CRLG/HW_AXIFACE/README.md

# HW_AXIFACE
Carte électronique AXIFACE pour servo-moteurs AX: schéma et routage
