CRLG/HW_AXIFACE/output/Axiface.pdf

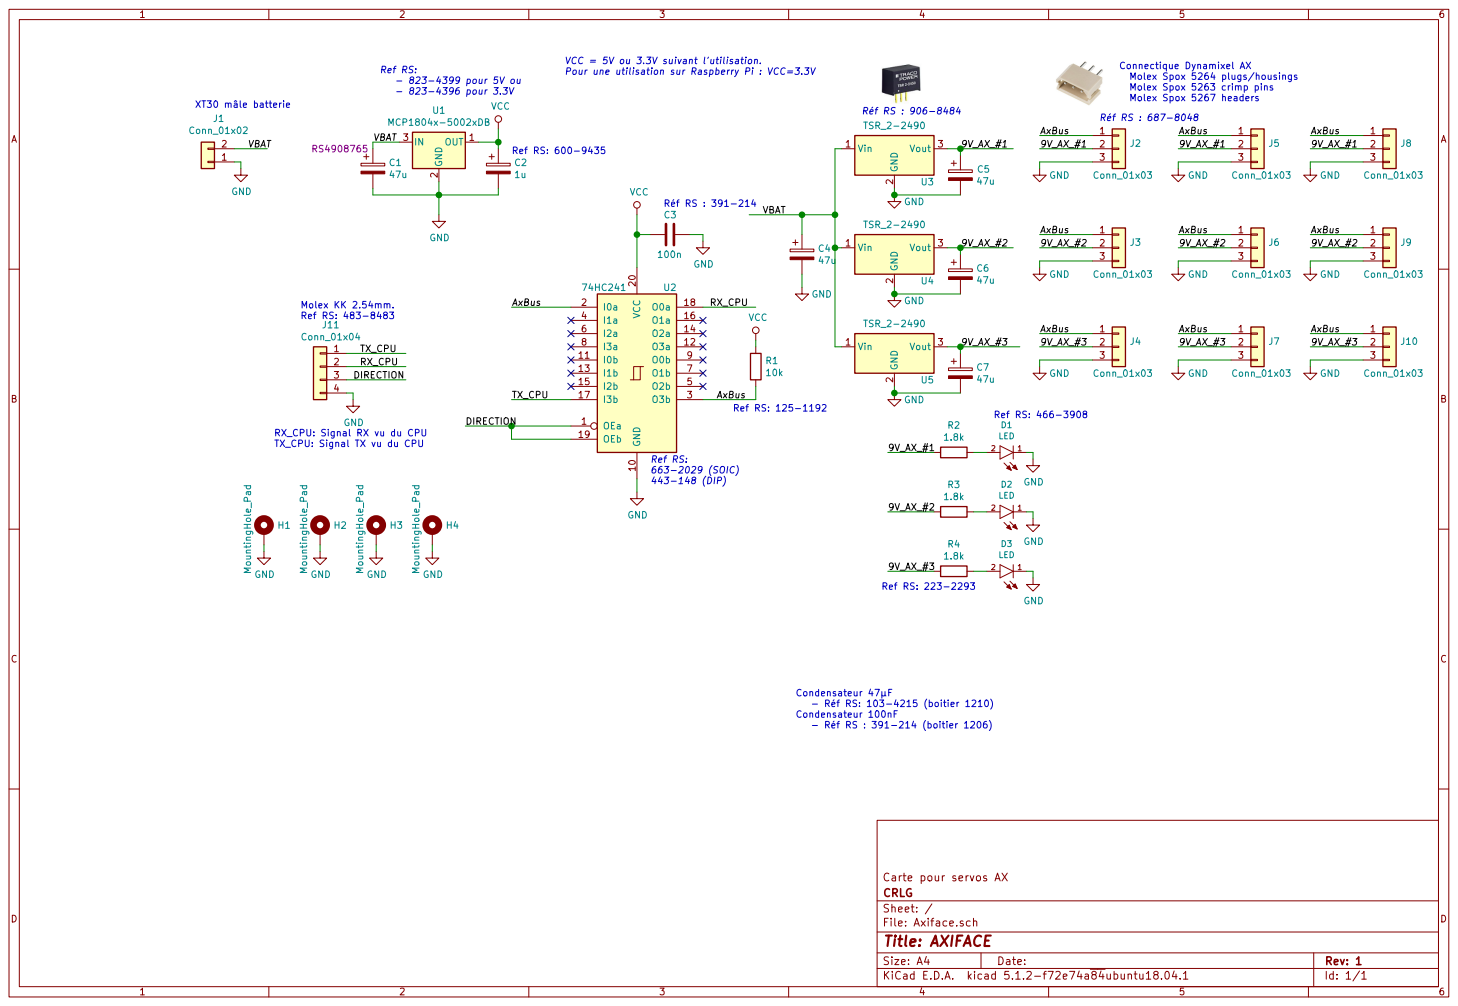
[picture p1: page 1]

Connectique Dynamixel AX
Molex Spox 5264 plugs/housings
Molex Spox 5263 crimp pins
Molex Spox 5267 headers Réf RS : 687-8048

2 Vout 3 U5 TSR_2-2490 GND GND GND

TX_CPU Molex KK 2.54mm. Ref RS: 483-8483
J11 Conn_01x04 GND

Ref RS: 223-2293 Ref RS: 125-1192

RX_CPU: Signal RX vu du CPU
TX_CPU: Signal TX vu du CPU

- Réf RS: 103-4215 (boitier 1210) Condensateur 100nF

Carte pour servos AX
File: Axiface.sch Sheet: / CRLG
