CRLG/HW_AXIFACE/Axiface.kicad_pcb

## KiCad design Axiface.kicad_pcb (2020-08-28)

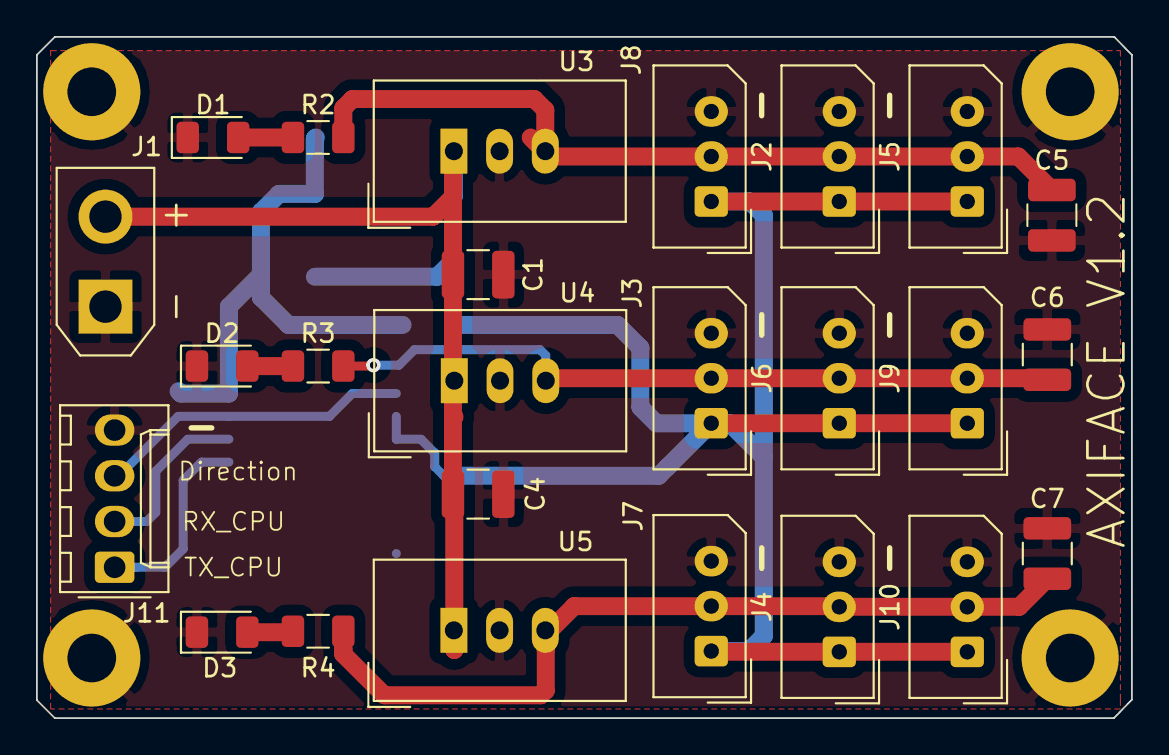
[picture p2: board Axiface.kicad_pcb from above]

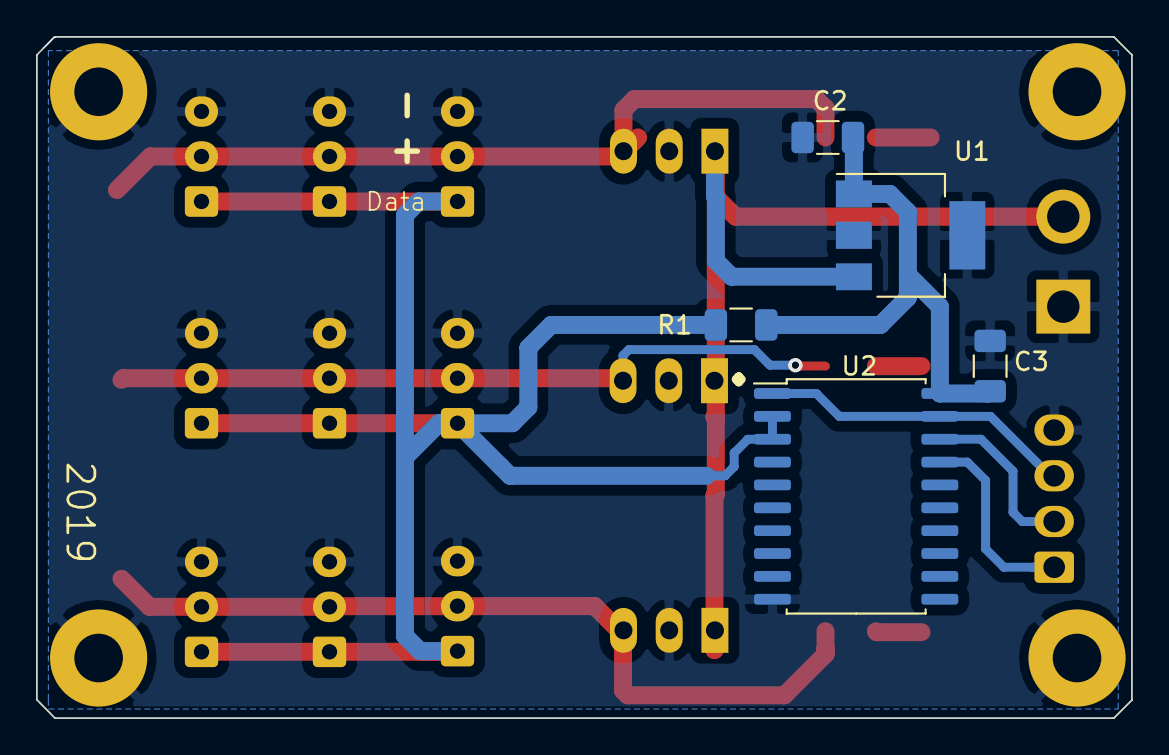
[picture p3: board Axiface.kicad_pcb from below]

Board: 2 copper layers, 60.8 x 37.8 mm, 34 parts (5 on the bottom side), 13 nets.

Parts:
C1, C4, C5, C6, C7: 47u; C_1210_3225Metric
C2: 1u; C_1206_3216Metric
C3: 100n; C_1206_3216Metric
D1, D2, D3: LED; LED_1206_3216Metric
H1, H2, H3, H4: MountingHole_Pad; MountingHole_2.7mm_M2.5_Pad
J1: Conn_01x02; AMASS_XT30UPB-F_1x02_P5.0mm_Vertical
J2, J3, J4, J5, J6, J7, J8, J9, J10: Conn_01x03; Molex_SPOX_5267-03A_1x03_P2.50mm_Vertical
J11: Conn_01x04; Molex_KK-254_AE-6410-04A_1x04_P2.54mm_Vertical
R1: 10k; R_1206_3216Metric
R2, R3, R4: 1.8k; R_1206_3216Metric
U1: MCP1804x-5002xDB; SOT-223-3_TabPin2
U2: 74HC241; SOIC-20W_7.5x12.8mm_P1.27mm
U3, U4, U5: TSR_2-2490; Converter_DCDC_TRACO_TSR-2_THT

Connections:
/9V_AX_#1: C5.1, J2.2, J5.2, J8.2, R2.2, U3.3
/9V_AX_#2: C6.1, J3.2, J6.2, J9.2, R3.2, U4.3
/9V_AX_#3: C7.1, J4.2, J7.2, J10.2, R4.2, U5.3
/AxBus: J2.1, J3.1, J4.1, J5.1, J6.1, J7.1, J8.1, J9.1, J10.1, R1.2, U2.2, U2.3
/DIRECTION: J11.3, U2.1, U2.19
/RX_CPU: J11.2, U2.18
/TX_CPU: J11.1, U2.17
/VBAT: C1.1, C4.1, J1.2, U1.3, U3.1, U4.1, U5.1
GND: C1.2, C2.2, C3.1, C4.2, C5.2, C6.2, C7.2, D1.1, D2.1, D3.1, H1.1, H2.1, H3.1, H4.1, J1.1, J2.3, J3.3, J4.3, J5.3, J6.3, J7.3, J8.3, J9.3, J10.3, J11.4, U1.2, U2.10, U3.2, U4.2, U5.2
unnamed: D1.2, R2.1
unnamed: D2.2, R3.1
unnamed: D3.2, R4.1
VCC: C2.1, C3.2, R1.1, U1.1, U2.20
