CRLG/HW_AXIFACE/(threads)

Thread 1 (2019-08-22):

Inversion sérigraphie entre RX_CPU et TX_CPU sur la version V1.1

NicoFarmer, 2019-08-22:
Sur la face supérieure, la sérigraphie est inversée entre RX_CPU et TX_CPU par rapport aux pins du connecteur J11.
La sérigraphie "_RX_CPU_" est placée devant la pin TX_CPU et inversement.
Cela concerne la version V1.1 et versions antérieures.

NicoFarmer, 2019-08-25:
Modification apportée en V1.2.
Correction du texte sur la couche Front (supérieure).

Closed 2019-08-25.
