CRLG/HW_AXIFACE/(commit log)

2019-06-23 Ajout de KICAD_LIB comme sous-module du projet
    KICAD_LIB est la librairie de composants et footprints CRLG pour KICAD
2019-06-24 Version en cours Axiface
    [Axiface.kicad_pcb, Axiface.sch]
2019-07-07 Mise à jour schématique + placement composants sur PCB
    [Axiface.kicad_pcb, Axiface.sch]
2019-07-11 Mise à jour du schéma et pcb
    [Axiface.kicad_pcb, Axiface.sch]
2019-07-11 Ajout de la lib convert DCDC au projet
2019-07-17 Mise à jour avant routage
    [Axiface.kicad_pcb, Axiface.sch]
2019-07-17 Mise à jour schéma + routage
    [Axiface.kicad_pcb, Axiface.sch]
2019-07-19 Dernières évolutions mineures avant mise en fabrication
    [Axiface-B_Cu.gbr, Axiface-B_Mask.gbr, Axiface-B_Paste.gbr, Axiface-B_SilkS.gbr, Axiface-Edge_Cuts.gbr, Axiface-F_Cu.gbr, Axiface-F_Mask.gbr, Axiface-F_Paste.gbr]
2019-07-30 Correction footprint TRACO TSR_2 + changement ref RS 47uF
    La référence initiale n'est plus distribuée chez RS
    Correction footprint
    [Axiface.sch]
2019-08-10 Correction erreur d'empreinte sur les Traco 9V
    [Axiface-B_Cu.gbr, Axiface-B_Mask.gbr, Axiface-B_Paste.gbr, Axiface-B_SilkS.gbr, Axiface-Edge_Cuts.gbr, Axiface-F_Cu.gbr, Axiface-F_Mask.gbr, Axiface-F_Paste.gbr]
2019-08-25 #1 Correction sérigraphie RX_CPU<->TX_CPU sur la couche supérieure
    [Axiface-B_Cu.gbr, Axiface-B_Mask.gbr, Axiface-B_Paste.gbr, Axiface-B_SilkS.gbr, Axiface-Edge_Cuts.gbr, Axiface-F_Cu.gbr, Axiface-F_Mask.gbr, Axiface-F_Paste.gbr]
2020-08-28 Mise à jour KICAD_LIB pour bénéfcier du modèle 3D de la carte en .step
    [Axiface.kicad_pcb]
